RickP/SUAD/README.md

# Shut up and die!

A hardware version of a bomb defusing game.

Image of the PCB

Made with a custom board and a Raspberry Pi Pico.
The firmware supplies the manual over a USB mass storage medium.
