RickP/SUAD/pcb/SUAD.kicad_pcb

## KiCad design pcb/SUAD.kicad_pcb (2022-04-09)

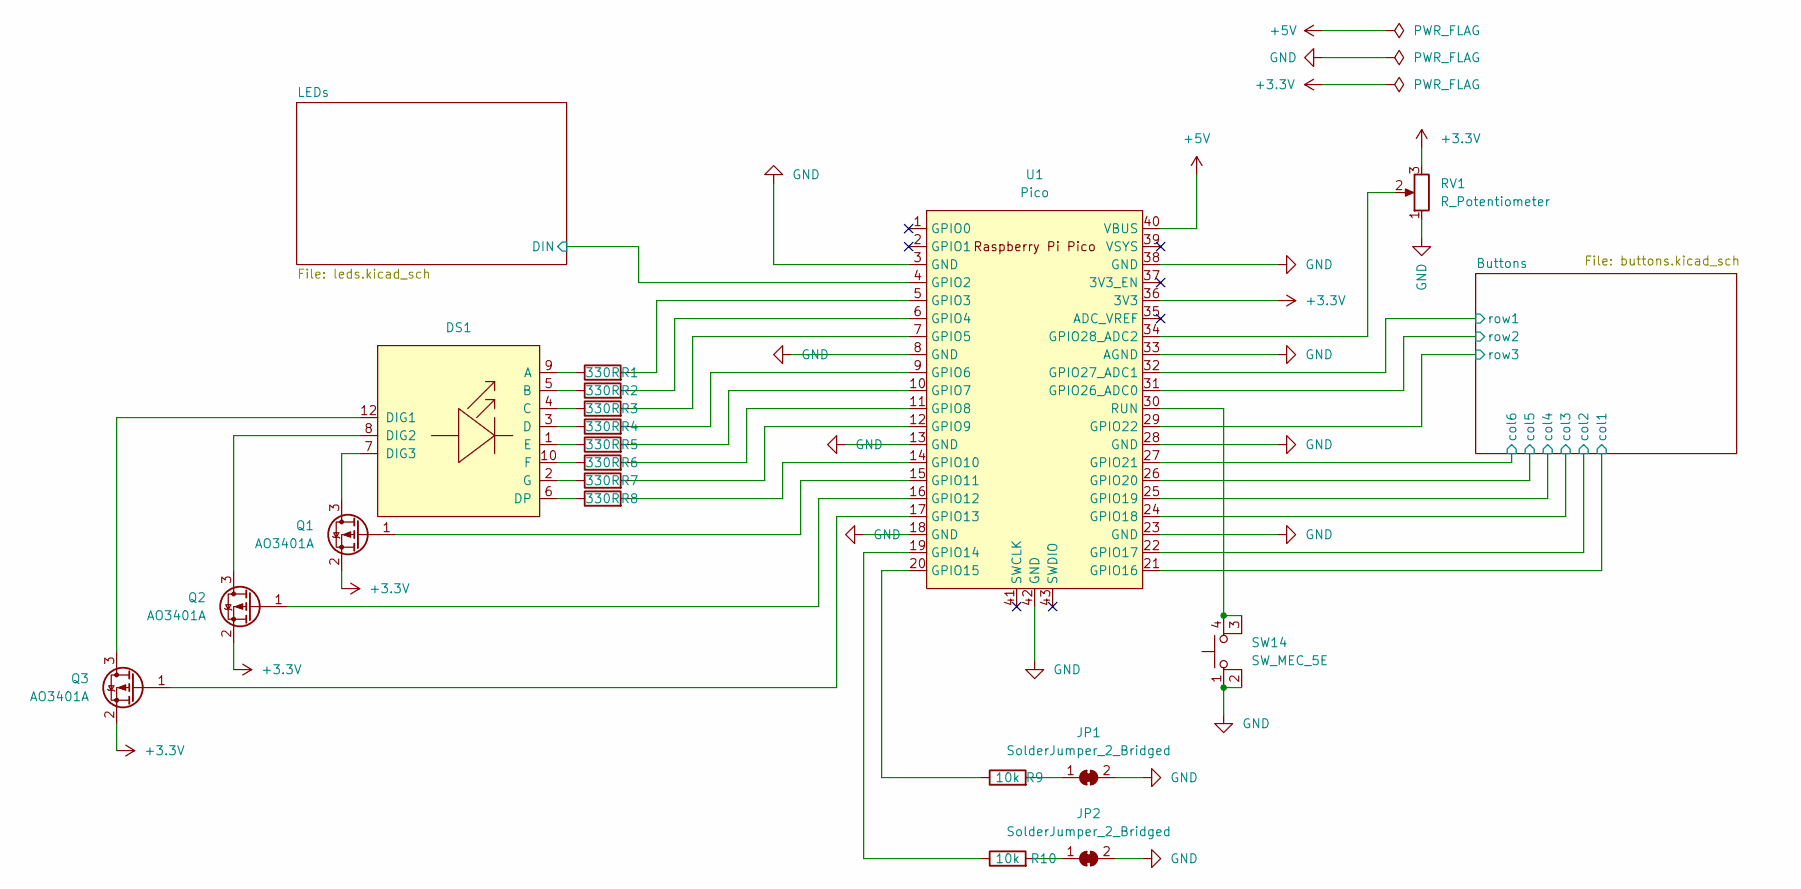
[picture p8: schematic SUAD.kicad_sch]

Parts:
DS1: SLS0563DRA1GD; LCSC C226010
JP1, JP2: SolderJumper_2_Bridged; SolderJumper-2_P1.3mm_Bridged_RoundedPad1.0x1.5mm
Q1, Q2, Q3: AO3401A; SOT-23; LCSC C15127
R1, R2, R3, R4, R5, R6, R7, R8: 330R; R_0603_1608Metric; LCSC C23138
R9, R10: 10k; R_0603_1608Metric; LCSC C25804
RV1: R_Potentiometer; RK10J11R001Y; LCSC C470765
SW14: SW_MEC_5E; TS-1187A-B-A-B; LCSC C318884
U1: Pico; RPi_Pico_SMD_TH

Connections:
+3V3: Q1.2 (S), Q2.2 (S), Q3.2 (S), RV1.3, U1.36 (3V3)
+5V: U1.40 (VBUS); also elsewhere on the board
/Buttons/col1: U1.21 (GPIO16); also elsewhere on the board
/Buttons/col2: U1.22 (GPIO17); also elsewhere on the board
/Buttons/col3: U1.24 (GPIO18); also elsewhere on the board
/Buttons/col4: U1.25 (GPIO19); also elsewhere on the board
/Buttons/col5: U1.26 (GPIO20); also elsewhere on the board
/Buttons/col6: U1.27 (GPIO21); also elsewhere on the board
/Buttons/row1: U1.32 (GPIO27_ADC1); also elsewhere on the board
/Buttons/row2: U1.31 (GPIO26_ADC0); also elsewhere on the board
/Buttons/row3: U1.29 (GPIO22); also elsewhere on the board
/LEDs/DIN: U1.4 (GPIO2); also elsewhere on the board
GND: JP1.2 (B), JP2.2 (B), RV1.1, SW14.1, SW14.2, U1.3 (GND), U1.8 (GND), U1.13 (GND), U1.18 (GND), U1.23 (GND), U1.28 (GND), U1.33 (AGND), U1.38 (GND), U1.42 (GND); also elsewhere on the board
unnamed: DS1.1 (E), R5.1
unnamed: DS1.2 (G), R7.1
unnamed: DS1.3 (D), R4.1
unnamed: DS1.4 (C), R3.1
unnamed: DS1.5 (B), R2.1
unnamed: DS1.6 (DP), R8.1
unnamed: DS1.7 (DIG3), Q1.3 (D)
unnamed: DS1.8 (DIG2), Q2.3 (D)
unnamed: DS1.9 (A), R1.1
unnamed: DS1.10 (F), R6.1
unnamed: DS1.12 (DIG1), Q3.3 (D)
unnamed: JP1.1 (A), R9.2
unnamed: JP2.1 (A), R10.2
unnamed: Q1.1 (G), U1.15 (GPIO11)
unnamed: Q2.1 (G), U1.16 (GPIO12)
unnamed: Q3.1 (G), U1.17 (GPIO13)
unnamed: R1.2, U1.5 (GPIO3)
unnamed: R2.2, U1.6 (GPIO4)
unnamed: R3.2, U1.7 (GPIO5)
unnamed: R4.2, U1.9 (GPIO6)
unnamed: R5.2, U1.10 (GPIO7)
unnamed: R6.2, U1.11 (GPIO8)
unnamed: R7.2, U1.12 (GPIO9)
unnamed: R8.2, U1.14 (GPIO10)
unnamed: R9.1, U1.20 (GPIO15)
unnamed: R10.1, U1.19 (GPIO14)
unnamed: RV1.2, U1.34 (GPIO28_ADC2)
unnamed: SW14.3 (K), SW14.4 (A), U1.30 (RUN)

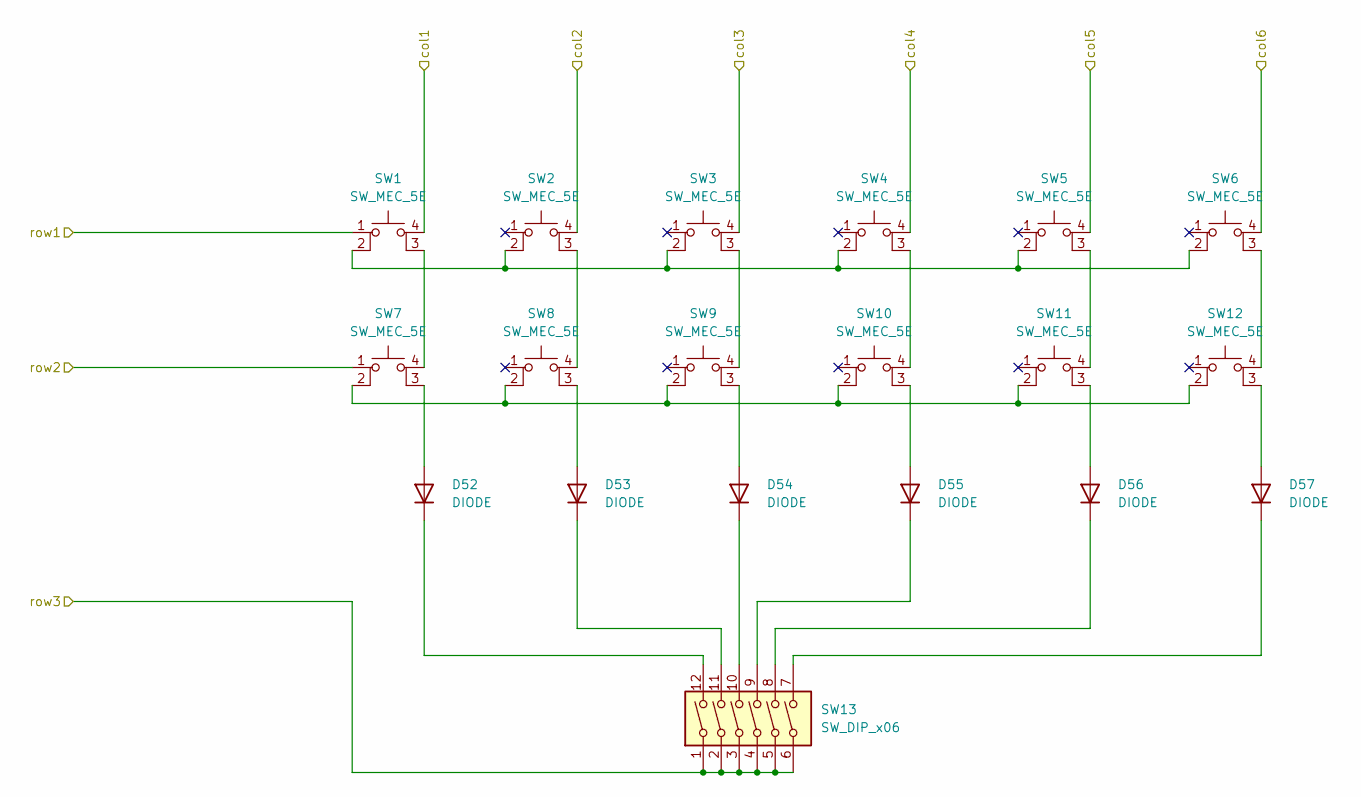
[picture p9: schematic buttons.kicad_sch]

Parts:
D52, D53, D54, D55, D56, D57: DIODE; D_SOD-123F; LCSC C64898
SW1, SW2, SW3, SW4, SW5, SW6, SW7, SW8, SW9, SW10, SW11, SW12: SW_MEC_5E; TS-1187A-B-A-B; LCSC C318884
SW13: SW_DIP_x06; SW_DIP_SPSTx06_Slide_6.7x16.8mm_W6.73mm_P2.54mm_LowProfile_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; LCSC C54952

Connections:
/Buttons/col1: SW1.4 (A); also elsewhere on the board
/Buttons/col2: SW2.4 (A); also elsewhere on the board
/Buttons/col3: SW3.4 (A); also elsewhere on the board
/Buttons/col4: SW4.4 (A); also elsewhere on the board
/Buttons/col5: SW5.4 (A); also elsewhere on the board
/Buttons/col6: SW6.4 (A); also elsewhere on the board
/Buttons/row1: SW1.1; also elsewhere on the board
/Buttons/row2: SW7.1; also elsewhere on the board
/Buttons/row3: SW13.1, SW13.2, SW13.3, SW13.4, SW13.5, SW13.6; also elsewhere on the board
unnamed: D52.1 (K), SW13.12
unnamed: D52.2 (A), SW7.3 (K)
unnamed: D53.1 (K), SW13.11
unnamed: D53.2 (A), SW8.3 (K)
unnamed: D54.1 (K), SW13.10
unnamed: D54.2 (A), SW9.3 (K)
unnamed: D55.1 (K), SW13.9
unnamed: D55.2 (A), SW10.3 (K)
unnamed: D56.1 (K), SW13.8
unnamed: D56.2 (A), SW11.3 (K)
unnamed: D57.1 (K), SW13.7
unnamed: D57.2 (A), SW12.3 (K)
unnamed: SW1.2, SW2.2, SW3.2, SW4.2, SW5.2, SW6.2
unnamed: SW1.3 (K), SW7.4 (A)
unnamed: SW2.3 (K), SW8.4 (A)
unnamed: SW3.3 (K), SW9.4 (A)
unnamed: SW7.2, SW8.2, SW9.2, SW10.2, SW11.2, SW12.2
unnamed: SW4.3 (K), SW10.4 (A)
unnamed: SW5.3 (K), SW11.4 (A)
unnamed: SW6.3 (K), SW12.4 (A)

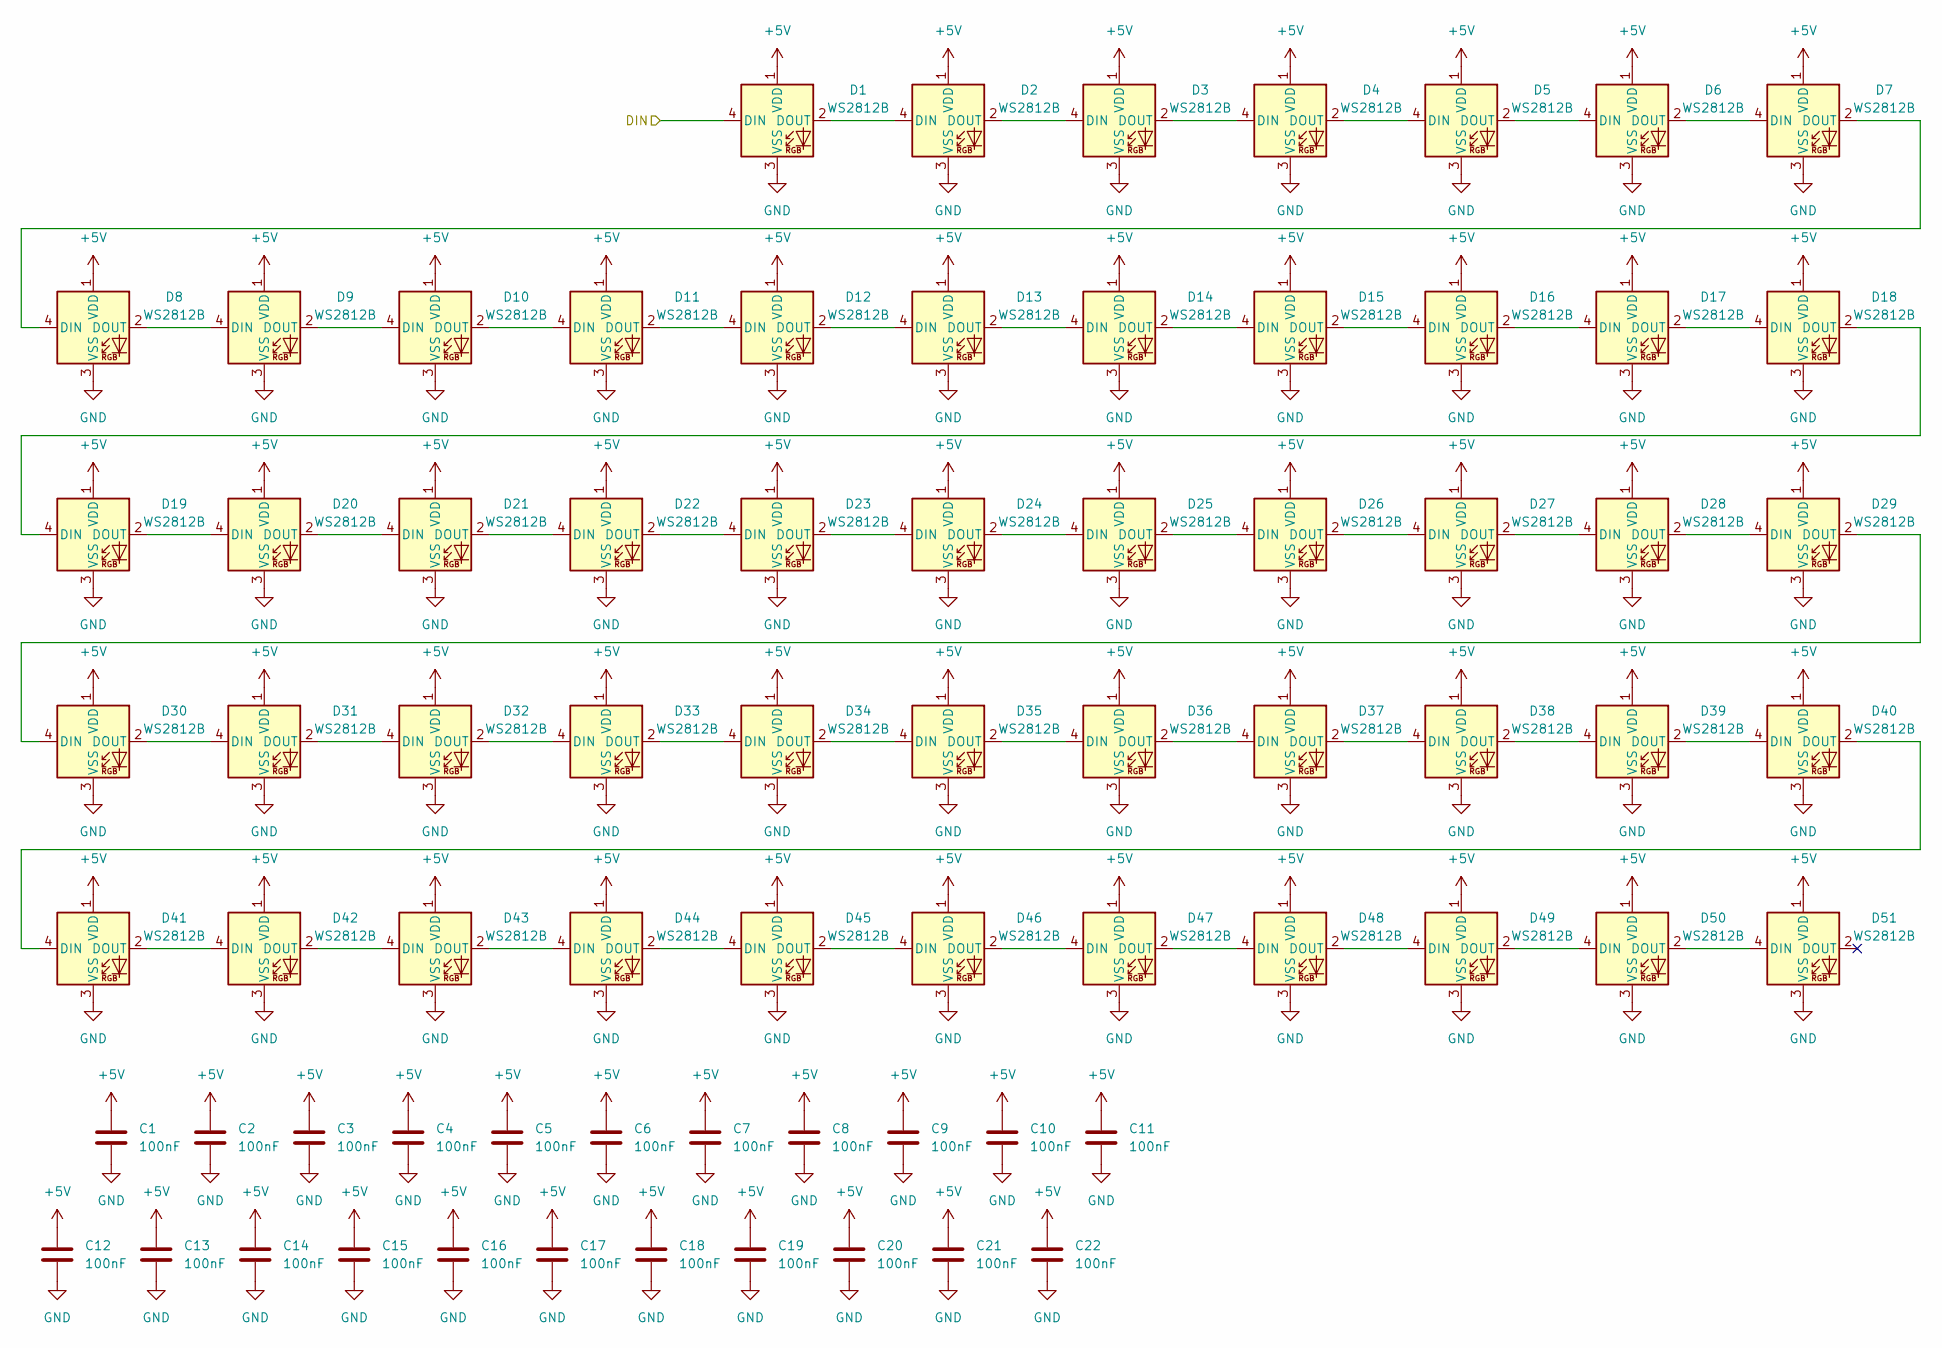
[picture p10: schematic leds.kicad_sch]

Parts:
C1, C2, C3, C4, C5, C6, C7, C8, C9, C10, C11, C12, C13, C14, C15, C16, C17, C18, C19, C20, C21, C22: 100nF; C_0603_1608Metric; LCSC C14663
D1, D2, D3, D4, D5, D6, D7, D8, D9, D10, D11, D12, D13, D14, D15, D16, D17, D18, D19, D20, D21, D22, D23, D24, D25, D26, D27, D28, D29, D30, D31, D32, D33, D34, D35, D36, D37, D38, D39, D40, D41, D42, D43, D44, D45, D46, D47, D48, D49, D50, D51: WS2812B; LED_WS2812B-Mini_3.5x3.5mm; LCSC C2890364

Connections:
+5V: C1.1, C2.1, C3.1, C4.1, C5.1, C6.1, C7.1, C8.1, C9.1, C10.1, C11.1, C12.1, C13.1, C14.1, C15.1, C16.1, C17.1, C18.1, C19.1, C20.1, C21.1, C22.1, D1.1 (VDD), D2.1 (VDD), D3.1 (VDD), D4.1 (VDD), D5.1 (VDD), D6.1 (VDD), D7.1 (VDD), D8.1 (VDD), D9.1 (VDD), D10.1 (VDD), D11.1 (VDD), D12.1 (VDD), D13.1 (VDD), D14.1 (VDD), D15.1 (VDD), D16.1 (VDD), D17.1 (VDD), D18.1 (VDD), D19.1 (VDD), D20.1 (VDD), D21.1 (VDD), D22.1 (VDD), D23.1 (VDD), D24.1 (VDD), D25.1 (VDD), D26.1 (VDD), D27.1 (VDD), D28.1 (VDD), D29.1 (VDD), D30.1 (VDD), D31.1 (VDD), D32.1 (VDD), D33.1 (VDD), D34.1 (VDD), D35.1 (VDD), D36.1 (VDD), D37.1 (VDD), D38.1 (VDD), D39.1 (VDD), D40.1 (VDD), D41.1 (VDD), D42.1 (VDD), D43.1 (VDD), D44.1 (VDD), D45.1 (VDD), D46.1 (VDD), D47.1 (VDD), D48.1 (VDD), D49.1 (VDD), D50.1 (VDD), D51.1 (VDD); also elsewhere on the board
/LEDs/DIN: D1.4 (DIN); also elsewhere on the board
GND: C1.2, C2.2, C3.2, C4.2, C5.2, C6.2, C7.2, C8.2, C9.2, C10.2, C11.2, C12.2, C13.2, C14.2, C15.2, C16.2, C17.2, C18.2, C19.2, C20.2, C21.2, C22.2, D1.3 (VSS), D2.3 (VSS), D3.3 (VSS), D4.3 (VSS), D5.3 (VSS), D6.3 (VSS), D7.3 (VSS), D8.3 (VSS), D9.3 (VSS), D10.3 (VSS), D11.3 (VSS), D12.3 (VSS), D13.3 (VSS), D14.3 (VSS), D15.3 (VSS), D16.3 (VSS), D17.3 (VSS), D18.3 (VSS), D19.3 (VSS), D20.3 (VSS), D21.3 (VSS), D22.3 (VSS), D23.3 (VSS), D24.3 (VSS), D25.3 (VSS), D26.3 (VSS), D27.3 (VSS), D28.3 (VSS), D29.3 (VSS), D30.3 (VSS), D31.3 (VSS), D32.3 (VSS), D33.3 (VSS), D34.3 (VSS), D35.3 (VSS), D36.3 (VSS), D37.3 (VSS), D38.3 (VSS), D39.3 (VSS), D40.3 (VSS), D41.3 (VSS), D42.3 (VSS), D43.3 (VSS), D44.3 (VSS), D45.3 (VSS), D46.3 (VSS), D47.3 (VSS), D48.3 (VSS), D49.3 (VSS), D50.3 (VSS), D51.3 (VSS); also elsewhere on the board
unnamed: D1.2 (DOUT), D2.4 (DIN)
unnamed: D2.2 (DOUT), D3.4 (DIN)
unnamed: D3.2 (DOUT), D4.4 (DIN)
unnamed: D4.2 (DOUT), D5.4 (DIN)
unnamed: D5.2 (DOUT), D6.4 (DIN)
unnamed: D6.2 (DOUT), D7.4 (DIN)
unnamed: D7.2 (DOUT), D8.4 (DIN)
unnamed: D8.2 (DOUT), D9.4 (DIN)
unnamed: D10.2 (DOUT), D11.4 (DIN)
unnamed: D9.2 (DOUT), D10.4 (DIN)
unnamed: D11.2 (DOUT), D12.4 (DIN)
unnamed: D12.2 (DOUT), D13.4 (DIN)
unnamed: D13.2 (DOUT), D14.4 (DIN)
unnamed: D14.2 (DOUT), D15.4 (DIN)
unnamed: D15.2 (DOUT), D16.4 (DIN)
unnamed: D16.2 (DOUT), D17.4 (DIN)
unnamed: D17.2 (DOUT), D18.4 (DIN)
unnamed: D18.2 (DOUT), D19.4 (DIN)
unnamed: D19.2 (DOUT), D20.4 (DIN)
unnamed: D20.2 (DOUT), D21.4 (DIN)
unnamed: D21.2 (DOUT), D22.4 (DIN)
unnamed: D22.2 (DOUT), D23.4 (DIN)
unnamed: D23.2 (DOUT), D24.4 (DIN)
unnamed: D24.2 (DOUT), D25.4 (DIN)
unnamed: D25.2 (DOUT), D26.4 (DIN)
unnamed: D26.2 (DOUT), D27.4 (DIN)
unnamed: D27.2 (DOUT), D28.4 (DIN)
unnamed: D28.2 (DOUT), D29.4 (DIN)
unnamed: D29.2 (DOUT), D30.4 (DIN)
unnamed: D30.2 (DOUT), D31.4 (DIN)
unnamed: D31.2 (DOUT), D32.4 (DIN)
unnamed: D32.2 (DOUT), D33.4 (DIN)
unnamed: D33.2 (DOUT), D34.4 (DIN)
unnamed: D34.2 (DOUT), D35.4 (DIN)
unnamed: D35.2 (DOUT), D36.4 (DIN)
unnamed: D36.2 (DOUT), D37.4 (DIN)
unnamed: D37.2 (DOUT), D38.4 (DIN)
unnamed: D38.2 (DOUT), D39.4 (DIN)
unnamed: D39.2 (DOUT), D40.4 (DIN)
unnamed: D40.2 (DOUT), D41.4 (DIN)
unnamed: D41.2 (DOUT), D42.4 (DIN)
unnamed: D42.2 (DOUT), D43.4 (DIN)
unnamed: D43.2 (DOUT), D44.4 (DIN)
unnamed: D44.2 (DOUT), D45.4 (DIN)
unnamed: D45.2 (DOUT), D46.4 (DIN)
unnamed: D46.2 (DOUT), D47.4 (DIN)
unnamed: D47.2 (DOUT), D48.4 (DIN)
unnamed: D48.2 (DOUT), D49.4 (DIN)
unnamed: D49.2 (DOUT), D50.4 (DIN)
unnamed: D50.2 (DOUT), D51.4 (DIN)

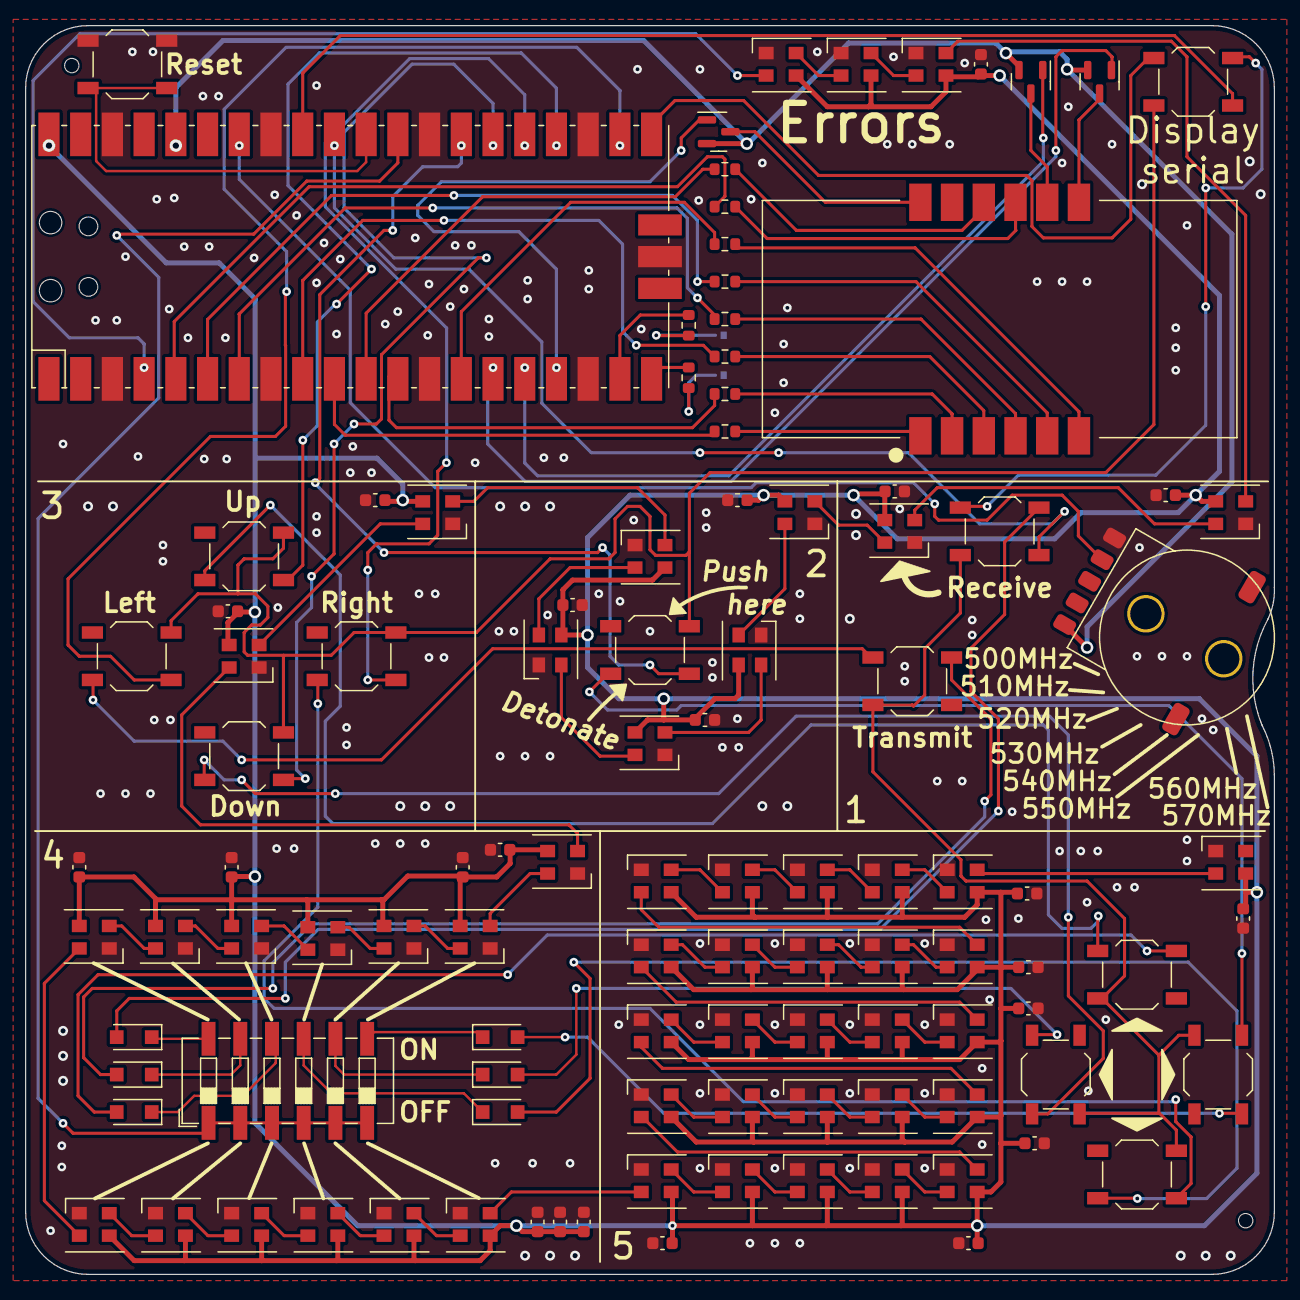
[picture p11: board SUAD.kicad_pcb from above]

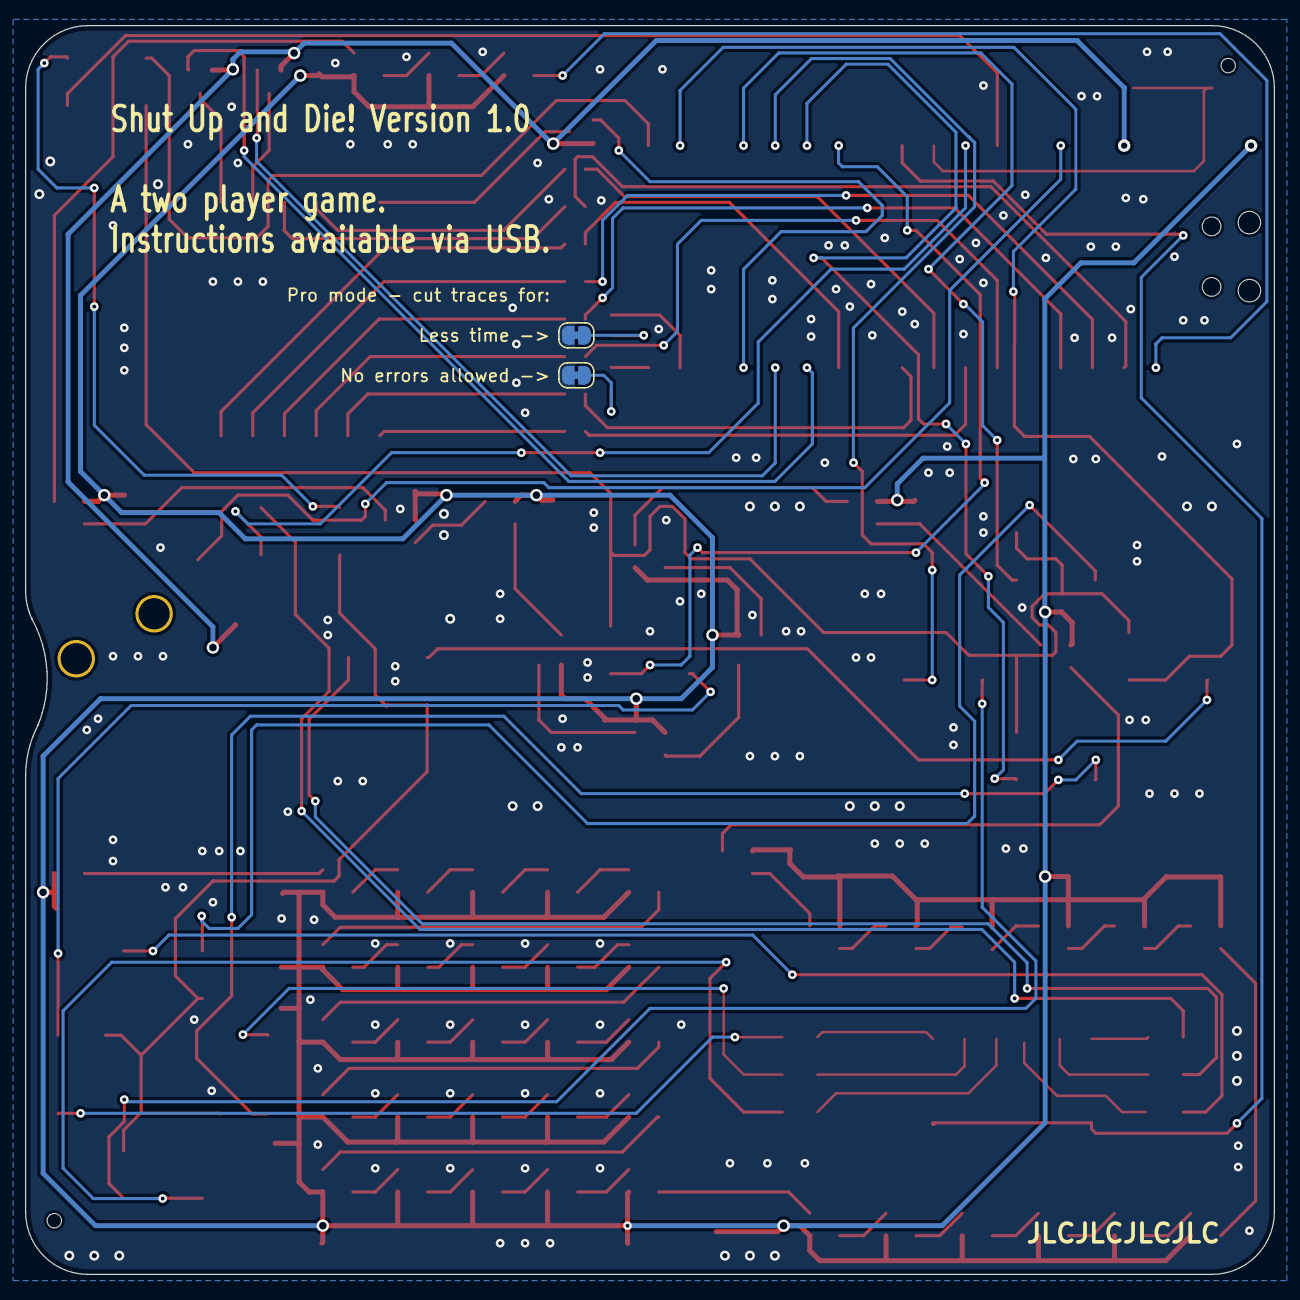
[picture p12: board SUAD.kicad_pcb from below]

Board: 2 copper layers, 100.0 x 100.0 mm, 111 parts (2 on the bottom side), 111 nets.
