RickP/SUAD/(commit log)

2022-02-07 Added pcb
    [JLC_DemoBoard.kicad_pcb, JLC_DemoBoard.sch, SUAD.kicad_pcb, SUAD.kicad_sch, SUAD_layout.kicad_pcb, buttons.kicad_sch, leds.kicad_sch]
2022-02-07 workflow trigger
    [SUAD.kicad_pcb]
2022-02-08 Fixed ERC and DRC
    [SUAD.kicad_pcb, SUAD.kicad_sch, leds.kicad_sch]
2022-02-08 use older kibot image
    [SUAD.kicad_pcb]
2022-02-09 Changed kibot config
    [SUAD.kicad_sch]
2022-02-15 Added firmware
    [SUAD.kicad_pcb]
2022-02-23 Added thread safety
2022-02-23 Got rid of fifo; Optimized WS2812 driver
2022-02-23 Use mask functions in display driver
2022-02-24 Added module handling, jumpers and fail/success"
    [core1.c, main.c]
2022-02-27 Various fixes; better fat16 stuff
    [core1.c, main.c, msc_disk.c]
2022-03-03 Added diodes to key matrix
    [SUAD.kicad_pcb, SUAD.kicad_sch, buttons.kicad_sch]
2022-03-03 Finished module 1
    [SUAD.kicad_pcb]
2022-03-22 Small fixed for new board
    [SUAD.kicad_pcb, SUAD_layout.kicad_pcb, buttons.kicad_sch]
2022-03-22 Silkscreen and footprint improvements
    [SUAD.kicad_pcb, SUAD.kicad_sch]
2022-04-09 PCB changes
    [SUAD.kicad_pcb]
